sKrible45/Dexclock/Clock Case Besel.stl

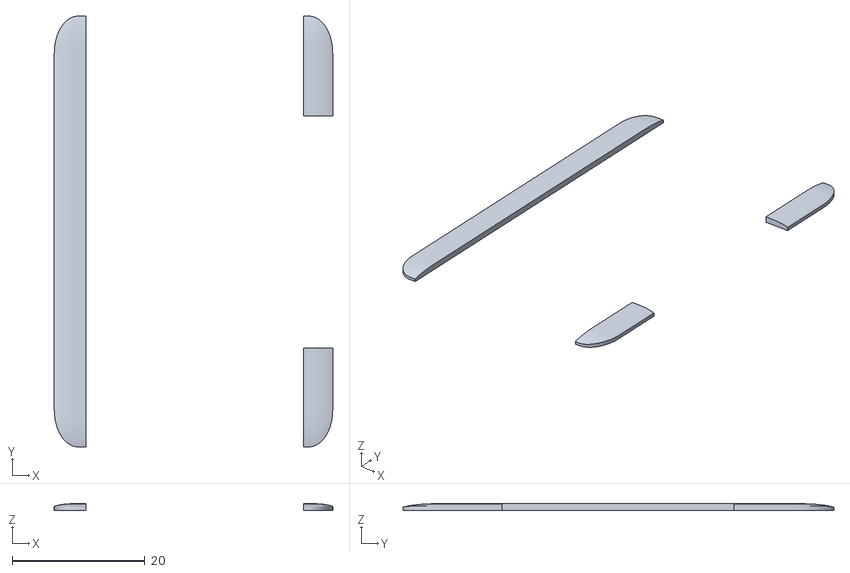
[picture p8: CAD file, 2023-08-13]
Clock Case Besel.stl
42.0 x 65.0 x 1
