sKrible45/Dexclock/Clock Case.stl

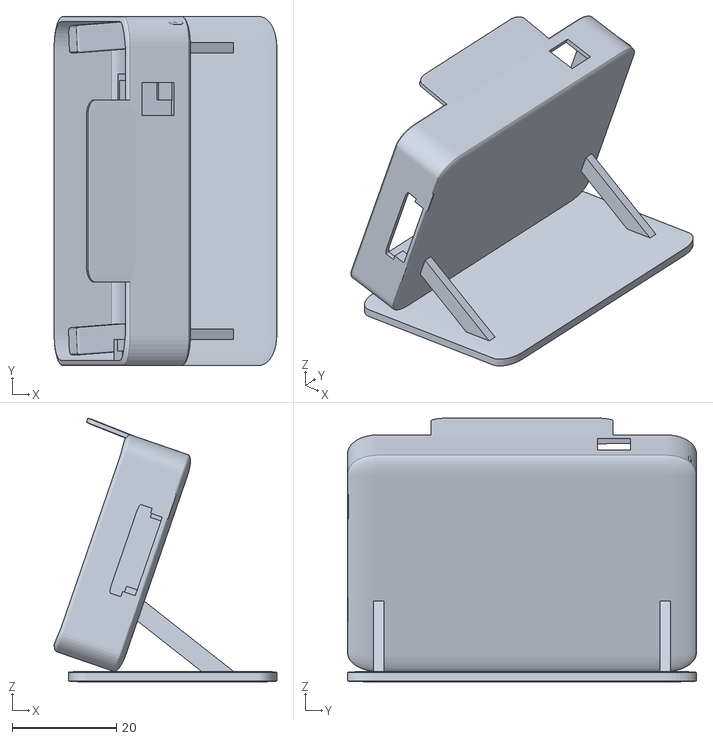
[picture p9: CAD file, 2023-08-13]
Clock Case.stl
42.7 x 67.0 x 50.6
